AmaiamUlHaque/Infinity-Mirror/media/image39.png

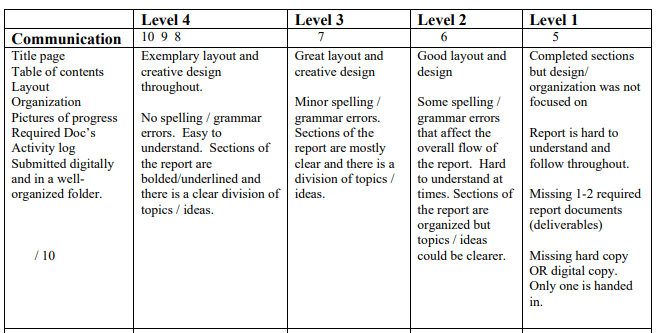
media/image39.png
