AmaiamUlHaque/Infinity-Mirror/media/image40.png

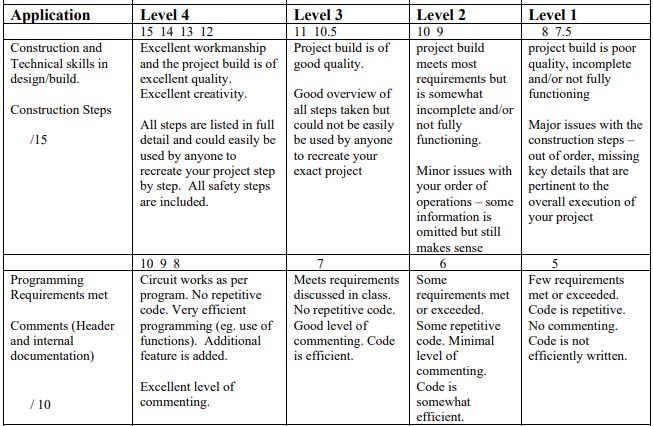
media/image40.png
