AmaiamUlHaque/Infinity-Mirror/media/image42.png

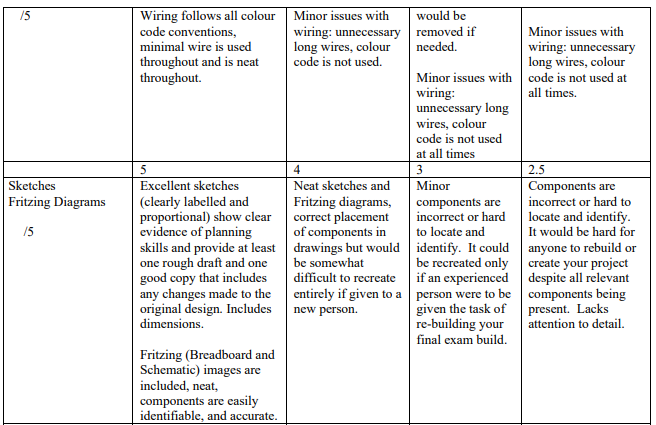
media/image42.png
