AmaiamUlHaque/Infinity-Mirror/(commit log)

2025-07-06 tested interrupts
2025-07-12 added various LED colour transitions
    colour transitions:
    - default
    - fade
    - spiral
    - reload
    - random
    - purples
2025-07-12 added methods for the LED strip
2025-07-15 integrated IR receiver and remote with LED
2025-07-19 oopsies fixing up the folder format
    [IRTranslate.ino, Infinity_Mirror.ino, Spiral.ino, a_declarations.ino, b_setup.ino, z_submission.ino]
